3DIY-Russia/Universal-touch-button-for-3D-printers/README.md

Кнопка сенсорная универсальная для 3D принтеров
