3DIY-Russia/Universal-touch-button-for-3D-printers/Часть аппаратная/КСУ V1.1.0 3D вид.png

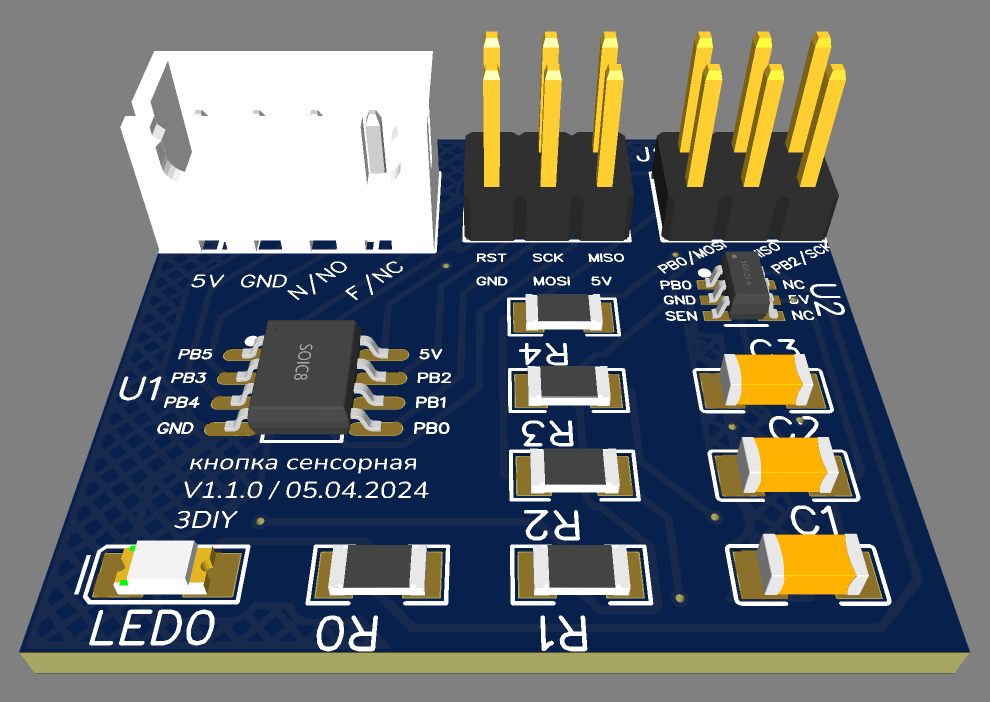
Часть аппаратная/КСУ V1.1.0 3D вид.png
