3DIY-Russia/Universal-touch-button-for-3D-printers/Часть аппаратная/КСУ V1.1.0 Размеры.dxf

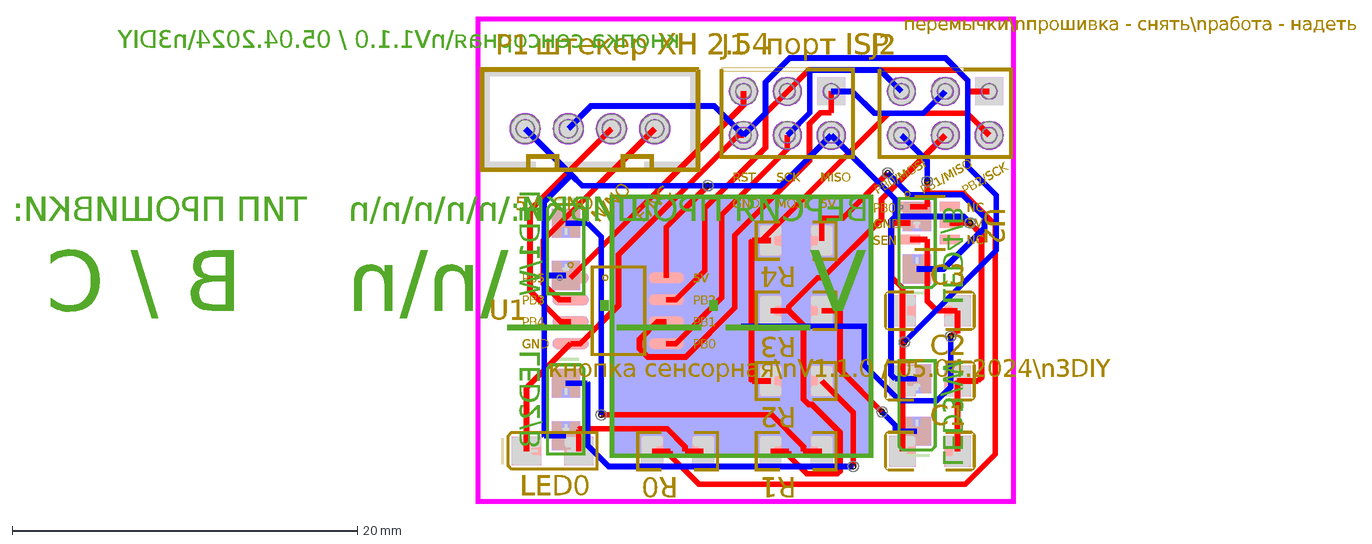
[picture p17: CAD file, 2024-04-05]
Часть аппаратная/КСУ V1.1.0 Размеры.dxf
PB0/MOSI
PB1/MISO
PB2/SCK
RST
SCK
MISO
MOSI
5V
GND
F/NC
N/NO
штекер XH 2.54
перемычки\nпрошивка - снять\nработа - надеть
NC
PB0
SEN
PB5
PB3
PB4
PB1
PB2
кнопка сенсорная\nV1.1.0 / 05.04.2024\n3DIY
ВЕРСИЯ ПРОШИВКИ:\n\n\n\n\n ТИП ПРОШИВКИ:
V__.__.__\n\n В / С
LED3/W
LED1/W
LED4/B
LED2/B
C1
C2
C3
порт ISP
J1
J2
P1
R1
U1
U2
R4
LED0
R0
R2
R3
