3DIY-Russia/Universal-touch-button-for-3D-printers/Часть аппаратная/КСУ V1.1.0 Схема принципиальная (схемотехника).pdf

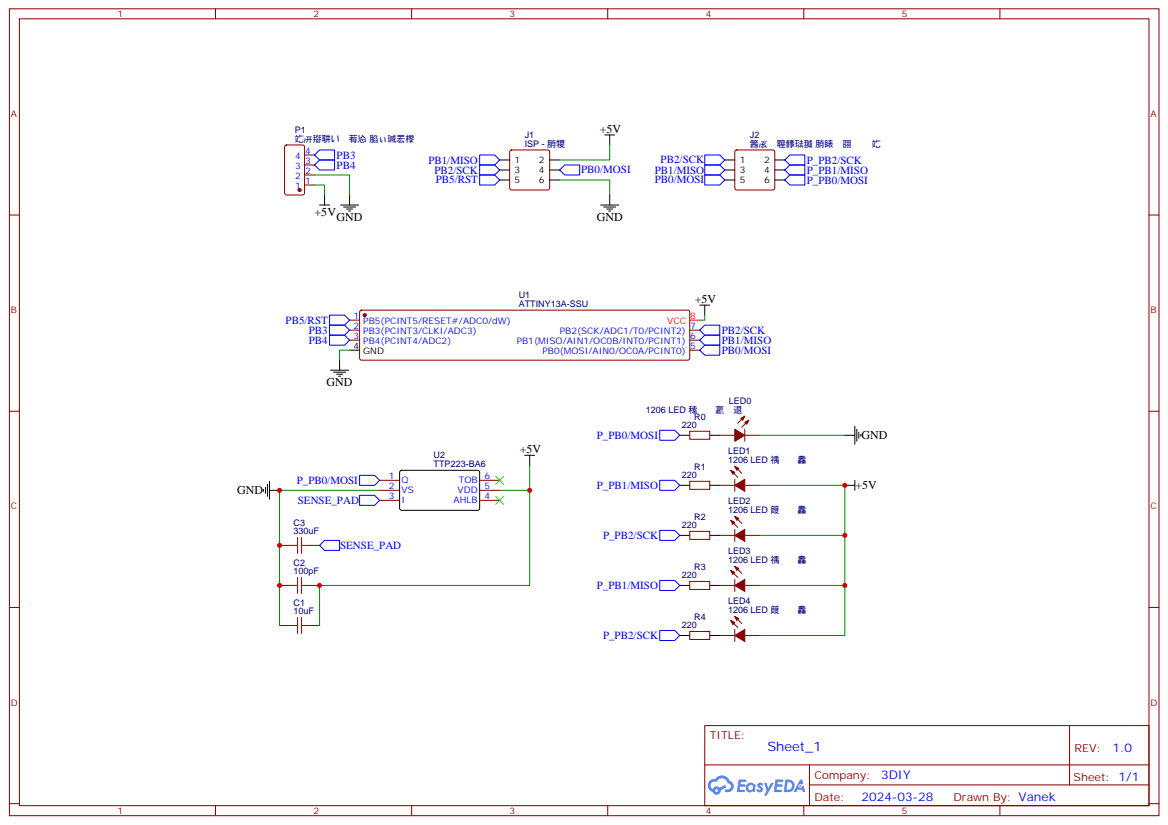
[picture p18: page 1]
